seongjin-yoon/can-based-autonomous-delivery-car/docs/팀 Catnip 프로젝트 수행계획서_인텔 1차 프로젝트.pdf

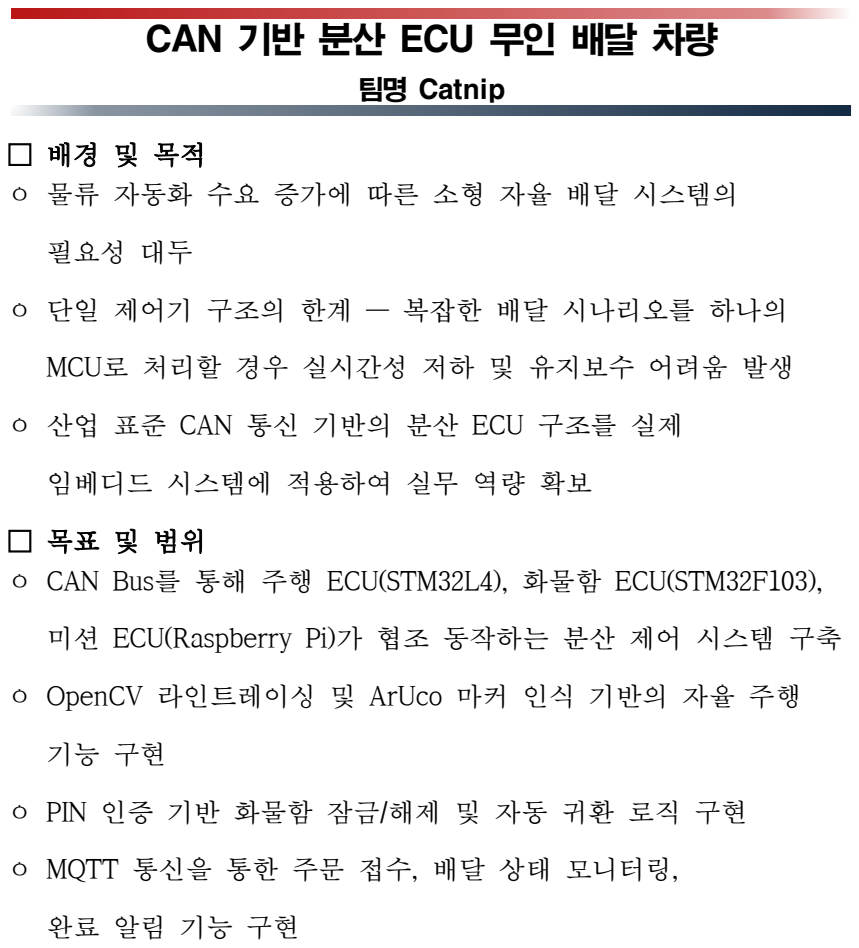
[picture p32: figure]
CAN 기반 분산 ECU 무인 배달 차량; 팀명 Catnip; ㅇ 물류 자동화 수요 증가에 따른 소형 자율 배달 시스템의; 필요성 대두; ㅇ 단일 제어기 구조의 한계 — 복잡한 배달 시나리오를 하나의; MCU로 처리할 경우 실시간성 저하 및 유지보수 어려움 발생; ㅇ 산업 표준 CAN 통신 기반의 분산 ECU 구조를 실제; 임베디드 시스템에 적용하여 실무 역량 확보; ㅇ OpenCV 라인트레이싱 및 ArUco 마커 인식 기반의 자율 주행; ㅇ PIN 인증 기반 화물함 잠금/해제 및 자동 귀환 로직 구현; ㅇ MQTT 통신을 통한 주문 접수, 배달 상태 모니터링,

ㅇ CAN Bus를 통해 주행 ECU(STM32L4), 화물함 ECU(STM32F103),

미션 ECU(Raspberry Pi)가 협조 동작하는 분산 제어 시스템 구축

ㅇ Qt 기반 클라이언트 UI에서 주문부터 배달 완료까지

전체 시나리오 동작 확인

□ 주요 기술 및 도구
ㅇ STM32L4, STM32F103, Raspberry Pi 5, CAN Bus(250kbps),

MQTT(Mosquitto), OpenCV, ArUco, Qt6, C/C++, SQLite

□ 주요 기능 및 예상 결과물
ㅇ CAN 프로토콜 기반 다중 ECU 분산 제어 (주행 / 화물함 / 미션)

ㅇ 라인트레이싱 + 교차로 판단 + 목적지별 경로 분기 자율 주행

ㅇ PIN 인증 기반 화물함 자동 개폐 및 미수령 시 자동 귀환

ㅇ MQTT 기반 실시간 주문·배달 상태 관리 서버 및 Qt 클라이언트 앱

□ 팀 구성 및 역할

성명 | 역할 | 성명 | 역할

구영모
(PM)

하드웨어 제작, 주행
ECU(STM32L$) - CAN
통신, 속도 제어 및
RPM 측정 뼈대 코드
작성, 화물함 ECU
(STM32F103) — CAN
통신

최지호
(Server)

서버 (RPi) — MQTT
브로커, SQLite DB,
주문 처리 로직, 클라이언트 UI (RPi) — Qt6 주문 앱, 배달 완료

알림, MQTT 연동

인수민
(PL)
윤성진
(Vision)

주행 테스트, 주행 ECU (STM32L4) — PID 속도 제어, 엔코더

RPM 측정, 상태머신, CAN/MQTT 연동

미션 ECU (RPi) — 라인트레이싱, ArUco

인식(Vision 담당),
마일스톤 제작

김민우
(QA)

화물함 ECU
(STM32F103) — PIN
인증, 서보 제어, CAN
통신 테스트, 클라이언트 UI (RPi) — Qt6 UX, 하드웨어

테스트, Flow Chart
제작

□ 프로젝트 일정

항목 | W+1 | W+2 | W+3 | W+4 | W+5 | W+6
주제 선정 및 설계
CAN 통신 및
ECU 개발
자율 주행 및
인증 구현
MQTT 서버/
Qt 클라이언트
통합 테스트
및 시연

□ 기대효과
ㅇ CAN Bus 기반 분산 ECU 구조를 통해 자동차·산업 제어 분야의 실무 아키텍처 직접 경험
ㅇ 실시간 제어(STM32) + 고수준 처리(Raspberry Pi) + 네트워크 통신(MQTT)을 통합한 풀스택 임베디드 시스템 구현 역량 확보 ㅇ 소형 무인 배달 차량 플랫폼으로서 물류 자동화 서비스 적용 가능성 확인
