seongjin-yoon/can-based-autonomous-delivery-car/assets/can.png

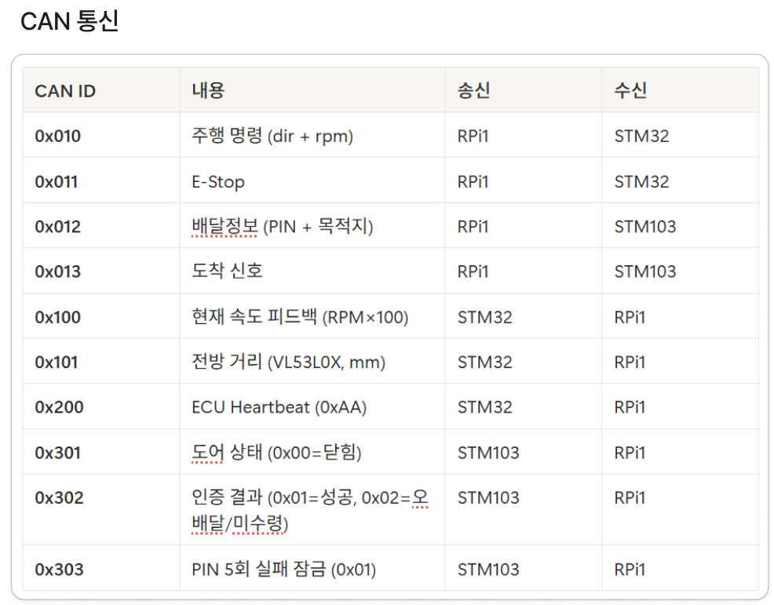
assets/can.png
