seongjin-yoon/can-based-autonomous-delivery-car/assets/cargo_hw.png

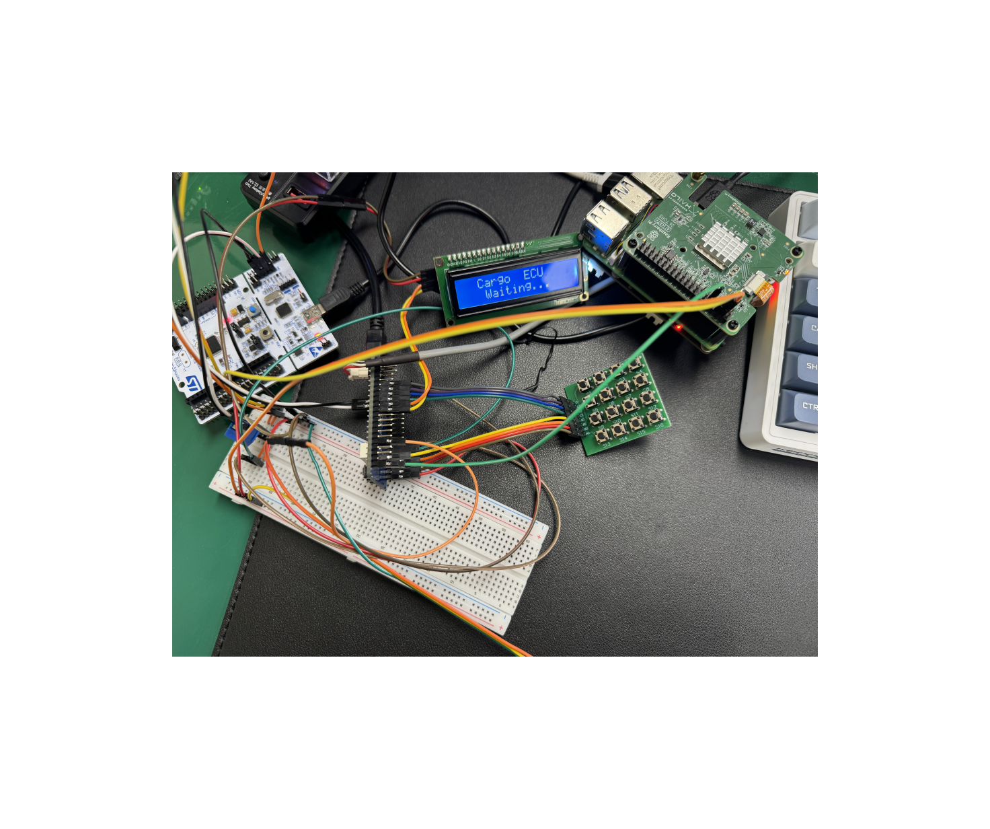
assets/cargo_hw.png
