seongjin-yoon/can-based-autonomous-delivery-car/assets/CATNIP (9).png

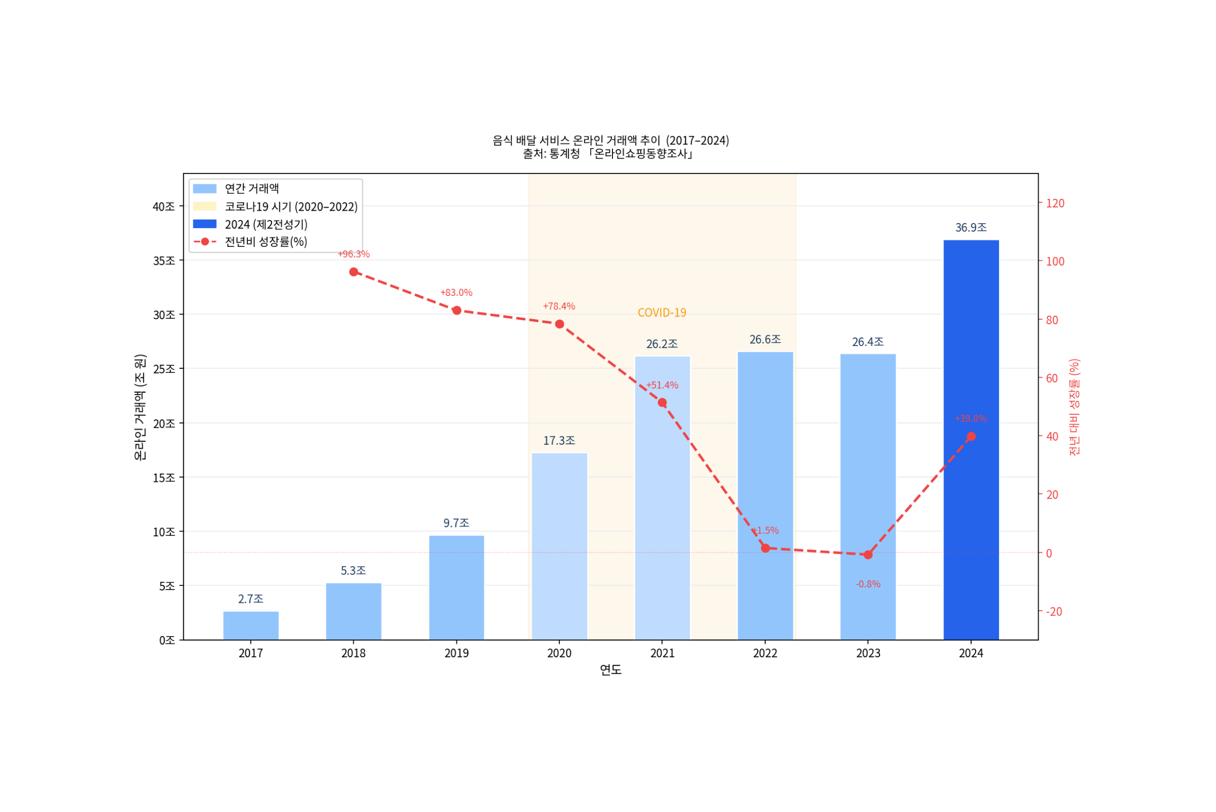
assets/CATNIP (9).png
