seongjin-yoon/can-based-autonomous-delivery-car/assets/CATNIP (11).png

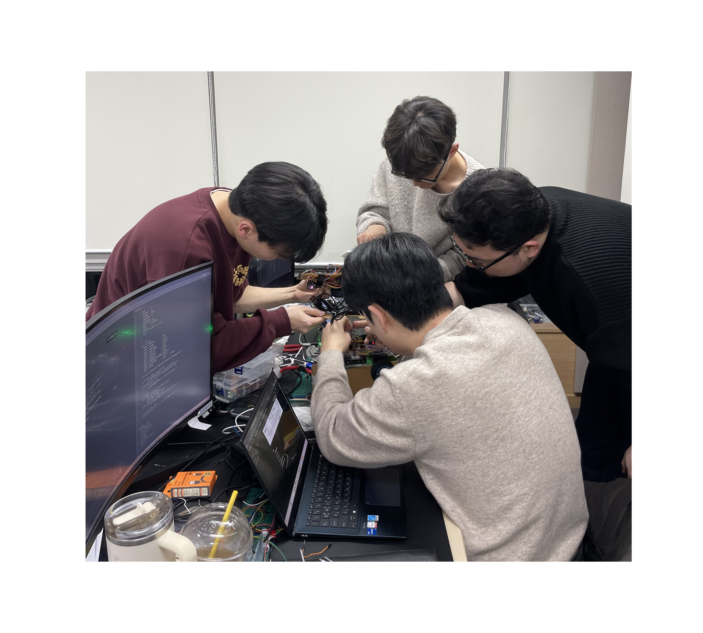
assets/CATNIP (11).png
