seongjin-yoon/can-based-autonomous-delivery-car/assets/hw (2).png

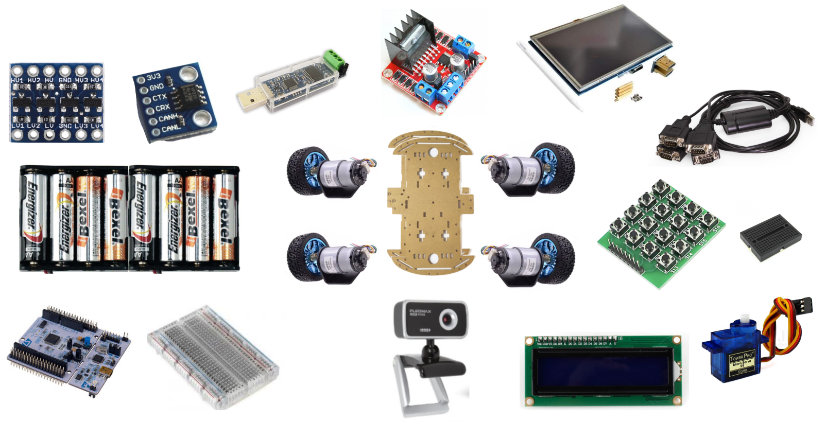
assets/hw (2).png
