seongjin-yoon/can-based-autonomous-delivery-car/assets/hw.png

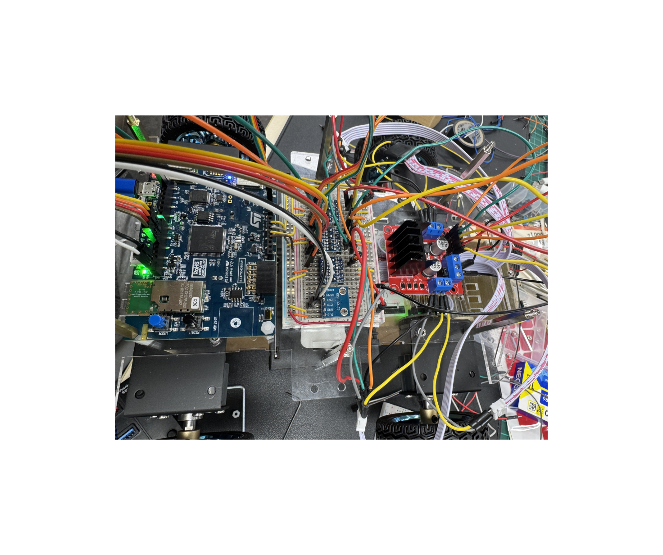
assets/hw.png
