seongjin-yoon/can-based-autonomous-delivery-car/assets/line_tracer3.png

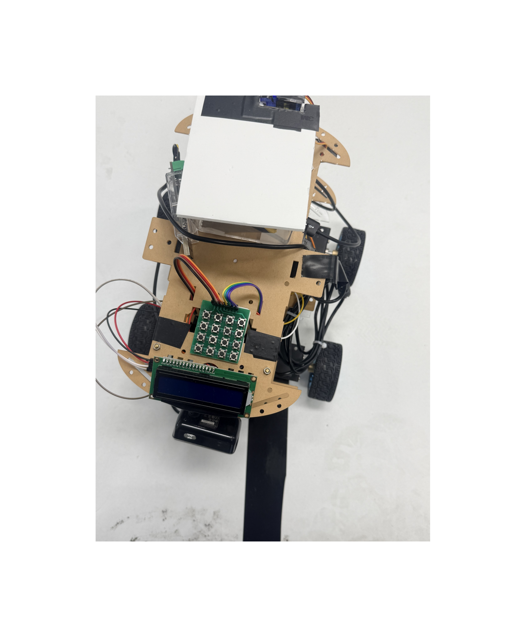
assets/line_tracer3.png
