seongjin-yoon/can-based-autonomous-delivery-car/assets/line_tracer5.png

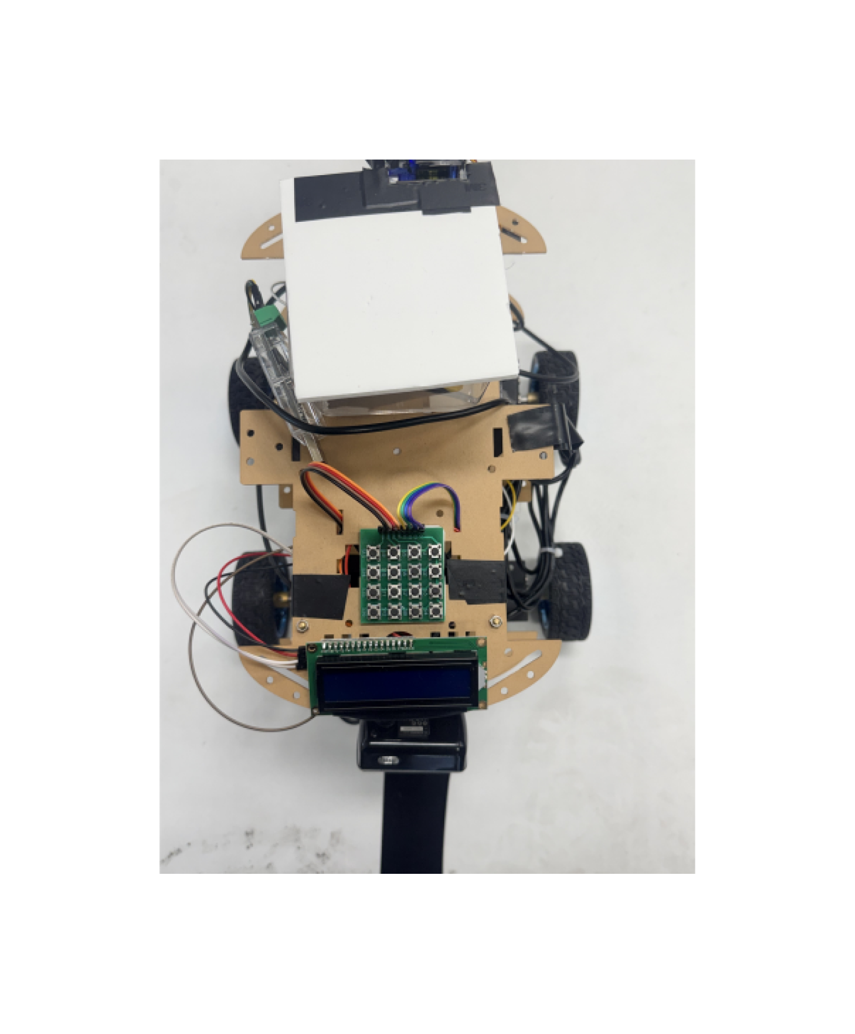
assets/line_tracer5.png
