seongjin-yoon/can-based-autonomous-delivery-car/assets/line_tracer6.png

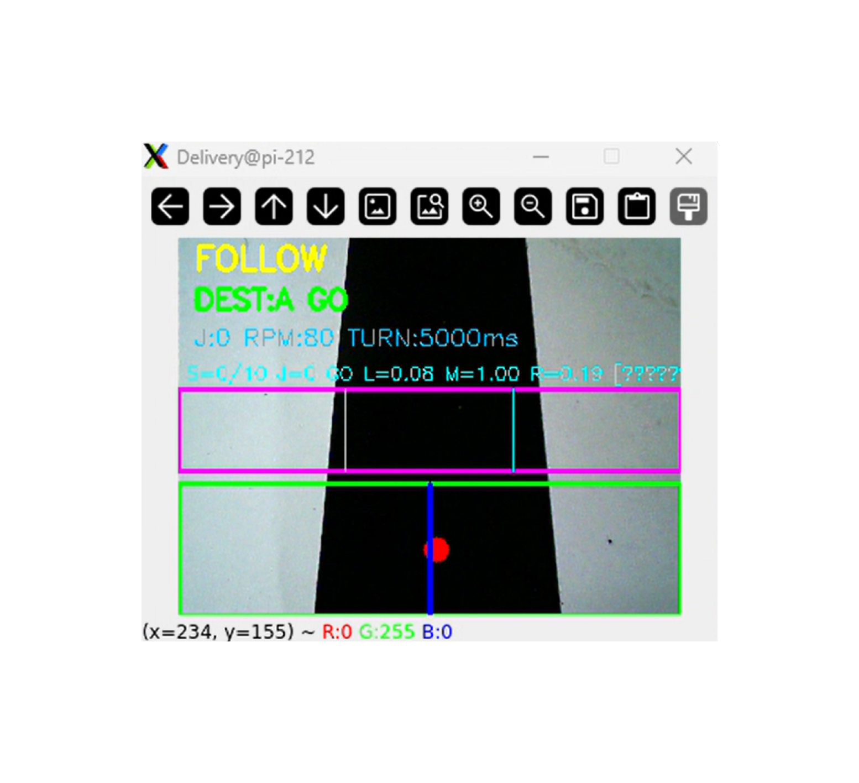
assets/line_tracer6.png
