seongjin-yoon/can-based-autonomous-delivery-car/assets/line_tracer.png

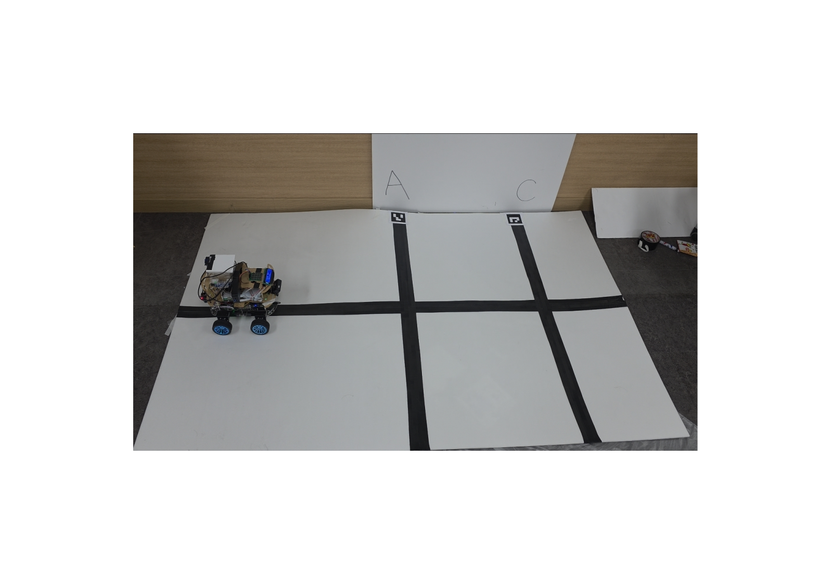
assets/line_tracer.png
