seongjin-yoon/can-based-autonomous-delivery-car/assets/line_tracer_2.png

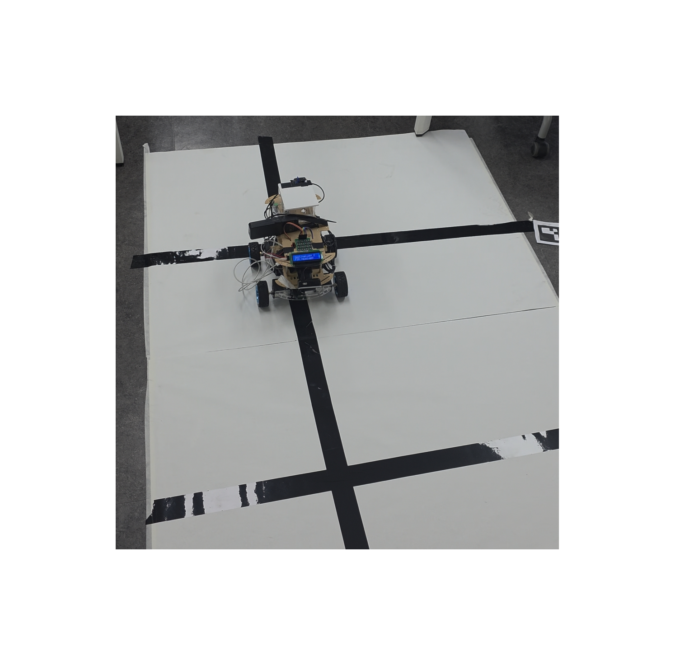
assets/line_tracer_2.png
