seongjin-yoon/can-based-autonomous-delivery-car/assets/mqtt.png

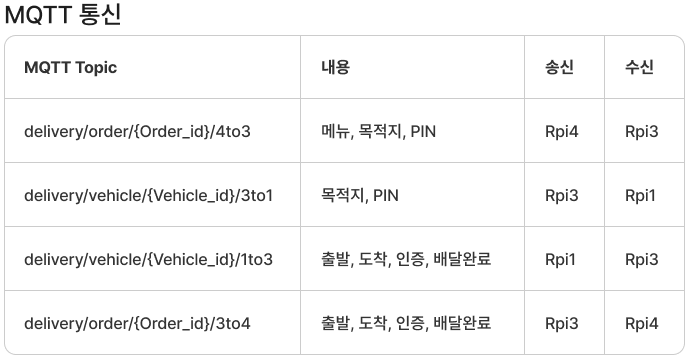
assets/mqtt.png
