seongjin-yoon/can-based-autonomous-delivery-car/assets/opencv.png

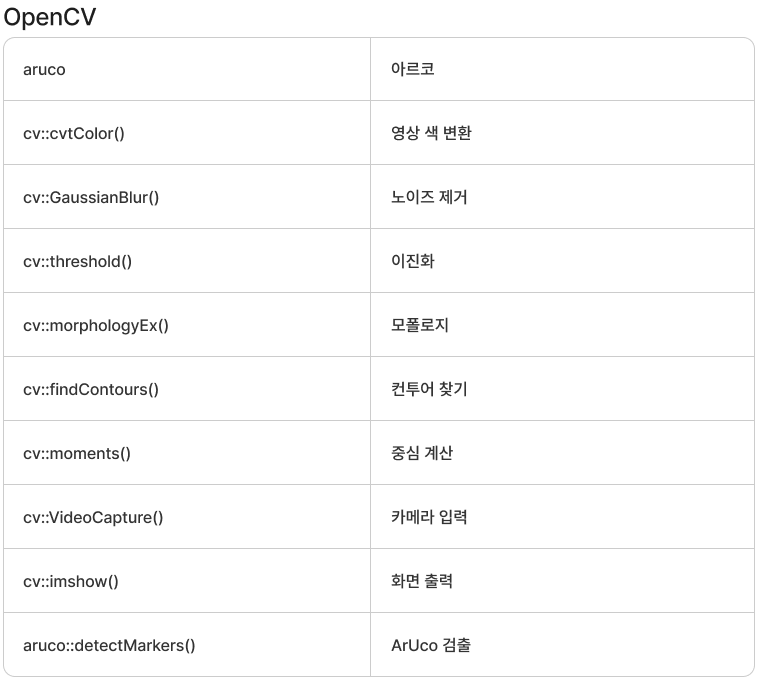
assets/opencv.png
