seongjin-yoon/can-based-autonomous-delivery-car/assets/rc_car_photo.png

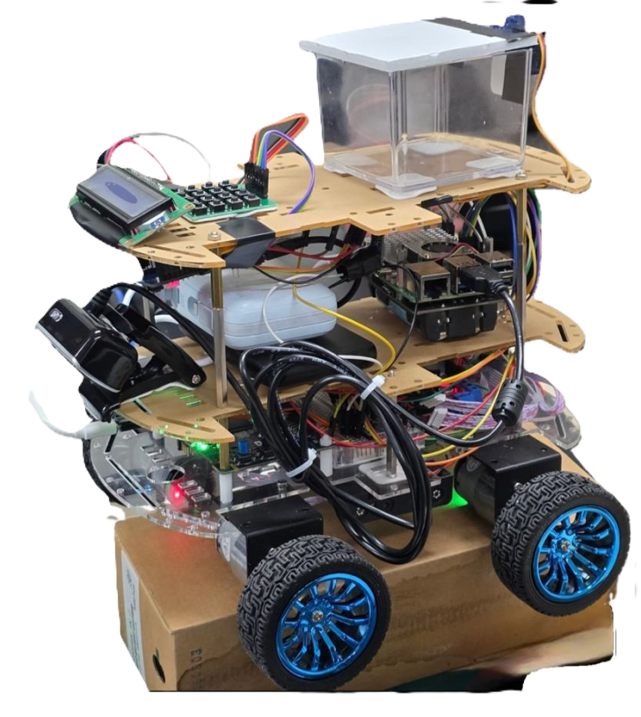
assets/rc_car_photo.png
