seongjin-yoon/can-based-autonomous-delivery-car/assets/st_link.png

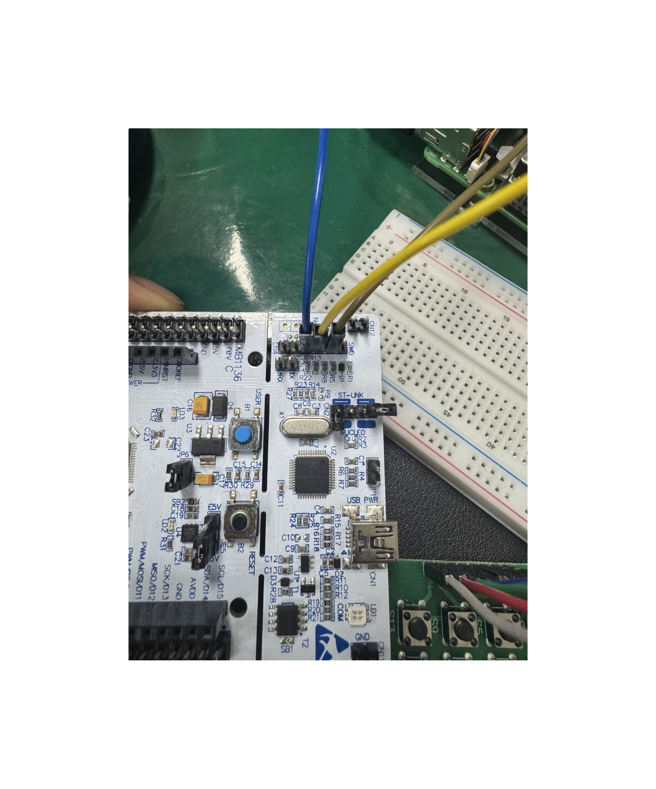
assets/st_link.png
