seongjin-yoon/can-based-autonomous-delivery-car/stmL4_drive/Core/Inc/main.h

#define BUTTON_EXTI13_Pin GPIO_PIN_13
#define BUTTON_EXTI13_GPIO_Port GPIOC
#define BUTTON_EXTI13_EXTI_IRQn EXTI15_10_IRQn
#define MOTOR_IN1_Pin GPIO_PIN_2
#define MOTOR_IN1_GPIO_Port GPIOC
#define MOTOR_IN2_Pin GPIO_PIN_3
#define MOTOR_IN2_GPIO_Port GPIOC
#define MOTOR_IN3_Pin GPIO_PIN_4
#define MOTOR_IN3_GPIO_Port GPIOC
#define MOTOR_IN4_Pin GPIO_PIN_5
#define MOTOR_IN4_GPIO_Port GPIOC
#define LED2_Pin GPIO_PIN_14
#define LED2_GPIO_Port GPIOB
#define USB_OTG_FS_PWR_EN_Pin GPIO_PIN_12
#define USB_OTG_FS_PWR_EN_GPIO_Port GPIOD
#define VL53L0X_XSHUT_Pin GPIO_PIN_6
#define VL53L0X_XSHUT_GPIO_Port GPIOC
#define VL53L0X_GPIO1_EXTI7_Pin GPIO_PIN_7
#define VL53L0X_GPIO1_EXTI7_GPIO_Port GPIOC
#define VL53L0X_GPIO1_EXTI7_EXTI_IRQn EXTI9_5_IRQn
#define LED3_WIFI__LED4_BLE_Pin GPIO_PIN_9
#define LED3_WIFI__LED4_BLE_GPIO_Port GPIOC
#define SYS_JTMS_SWDIO_Pin GPIO_PIN_13
#define SYS_JTMS_SWDIO_GPIO_Port GPIOA
#define SYS_JTCK_SWCLK_Pin GPIO_PIN_14
#define SYS_JTCK_SWCLK_GPIO_Port GPIOA
