seongjin-yoon/can-based-autonomous-delivery-car/rpi1_mission/mission_ecu.cpp

/*
 * delivery_mqtt_merge10.cpp
 * 라인트레이싱 + ArUco + MQTT 통합 버전
 *
 * 수정사항 (merge10):
 *   1. VehicleMQTT 클래스를 recv_can 앞으로 이동 (컴파일 오류 수정)
 *   2. recv_can(sock) → recv_can(sock, mqtt) 인자 수정
 *   3. MQTT 구독 토픽 /destination → /order 수정
 *   4. last_junc = t → last_junc = 0 (첫 교차로 쿨다운 제거)
 *   5. 유턴 후 복귀 시도 last_junc = 0 (복귀 첫 교차로도 즉시 인식)
 *
 * 컴파일:
 *   g++ delivery_mqtt_merge10.cpp -o delivery10 \
 *       $(pkg-config --cflags --libs opencv4) \
 *       -lmosquittopp -lpthread
 * 실행:
 *   ./delivery10 [broker_ip]
 */

#include <opencv2/opencv.hpp>
#include <opencv2/aruco.hpp>
#include <mosquittopp.h>
#include <nlohmann/json.hpp>
#include <stdio.h>
#include <stdlib.h>
#include <string.h>
#include <unistd.h>
#include <termios.h>
#include <net/if.h>
#include <sys/socket.h>
#include <sys/ioctl.h>
#include <linux/can.h>
#include <linux/can/raw.h>
#include <stdint.h>
#include <sys/select.h>
#include <time.h>
#include <cmath>
#include <fcntl.h>
#include <errno.h>
#include <vector>
#include <thread>
#include <atomic>
#include <string>
#include <sstream>
#include <iomanip>

using json = nlohmann::json;

// ===================== CAN ID 정의 =====================
#define CAN_MOTOR_CMD     0x010
#define CAN_MOTOR_ESTOP   0x011
#define CAN_CARGO_INFO    0x012
#define CAN_CARGO_ARRIVE  0x013
#define CAN_DOOR_STATUS   0x301
#define CAN_AUTH_RESULT   0x302
#define CAN_LOCKED        0x303

// ===================== 모터 명령 코드 =====================
#define DIR_STOP      0
#define DIR_FORWARD   1
#define DIR_BACKWARD  2
#define DIR_LEFT      3
#define DIR_RIGHT     4
#define DIR_UTURN     5

// ===================== 주행 파라미터 =====================
#define DEFAULT_RPM       50.0f
#define TURN_RPM          150.0f
#define UTURN_RPM         200.0f   // ★ 유턴은 더 강하게
#define STRAIGHT_DEADBAND 50

// ===================== 교차로 감지 파라미터 =====================
#define JUNC_STREAK       2
#define JUNC_START_DELAY  3000
#define JUNC_COOLDOWN_MS  3500
#define HIGH_TH           0.40f
#define HIGH_TH_ONE       0.65f
#define MID_TH            0.40f

// ===================== 상태 지속 시간 =====================
#define DUR_JUNC_STOP_MS      800
#define DUR_STRAIGHT_MS       2000
#define DUR_TURN_MS           3000
#define DUR_UTURN_MS          3000
#define DUR_REACQ_MS          1500   // ★ 500 → 1500ms (회전 후 라인 정렬 시간 확보)
#define DUR_REACQ_UTURN_MS    1000
#define REACQ_RPM             30.0f  // ★ 재조정 시 저속

// ===================== 상태머신 =====================
typedef enum {
    S_WAIT_CMD,
    S_FOLLOW,
    S_JUNC_STOP,
    S_JUNC_STRAIGHT,
    S_JUNC_LEFT,
    S_JUNC_RIGHT,
    S_REACQUIRE,
    S_REACQ_STABLE,        // ★ REACQ 완료 후 직진 안정화
    S_REACQUIRE_AFTER_UTURN,
    S_DELIVER_WAIT,
    S_PRE_UTURN,   // ★ 도어 닫힘 후 직진 → 유턴 준비
    S_UTURN,
    S_FINISHED
} State;

typedef enum { J_NONE, J_PLUS, J_T } JuncType;

// ===================== 전역 변수 =====================
static struct termios orig_termios;
static float          g_rpm         = DEFAULT_RPM;
static uint8_t        g_next_action = DIR_FORWARD;
static uint8_t        g_reacq_dir   = DIR_FORWARD; // ★ REACQUIRE 진입 방향

static std::atomic<int>  g_destination(0);
static std::atomic<bool> g_start_cmd(false);
static std::atomic<bool> g_running(true);
static std::atomic<bool> g_door_closed(false);
static std::string       g_delivery_id = "";
static std::string       g_vehicle_id  = "vehicle_001";

// ===================== 목적지별 교차로 행동 =====================
static uint8_t get_junction_action(int dest, int junc_count, bool returning) {
    if (!returning) {
        switch (dest) {
            case 1: if (junc_count == 0) return DIR_LEFT;    break;
            case 2: if (junc_count == 0) return DIR_RIGHT;   break;
            case 3:
                if (junc_count == 0) return DIR_FORWARD;
                if (junc_count == 1) return DIR_LEFT;
                break;
            case 4:
                if (junc_count == 0) return DIR_FORWARD;
                if (junc_count == 1) return DIR_RIGHT;
                break;
        }
    } else {
        switch (dest) {
            case 1: if (junc_count == 0) return DIR_RIGHT;   break;
            case 2: if (junc_count == 0) return DIR_LEFT;    break;
            case 3:
                if (junc_count == 0) return DIR_RIGHT;
                if (junc_count == 1) return DIR_FORWARD;
                break;
            case 4:
                if (junc_count == 0) return DIR_LEFT;
                if (junc_count == 1) return DIR_FORWARD;
                break;
        }
    }
    return DIR_FORWARD;
}

static int get_target_aruco(int dest) { return dest; }
static int get_max_junc(int dest) {
    if (dest == 1 || dest == 2) return 1;
    return 2;
}

// ===================== 유틸 =====================
static uint64_t now_ms() {
    struct timespec ts;
    clock_gettime(CLOCK_MONOTONIC, &ts);
    return (uint64_t)ts.tv_sec * 1000ULL + ts.tv_nsec / 1000000ULL;
}

static std::string get_timestamp() {
    auto now = std::time(nullptr);
    auto tm  = *std::localtime(&now);
    std::ostringstream oss;
    oss << std::put_time(&tm, "%Y-%m-%d %H:%M:%S");
    return oss.str();
}

void term_raw_on() {
    struct termios raw;
    tcgetattr(STDIN_FILENO, &orig_termios);
    raw = orig_termios;
    raw.c_lflag &= ~(ICANON | ECHO);
    raw.c_cc[VMIN] = 1; raw.c_cc[VTIME] = 0;
    tcsetattr(STDIN_FILENO, TCSAFLUSH, &raw);
}
void term_raw_off() { tcsetattr(STDIN_FILENO, TCSAFLUSH, &orig_termios); }

// ===================== CAN 송신 =====================
void send_cmd(int sock, uint8_t dir, float rpm) {
    struct can_frame frame;
    memset(&frame, 0, sizeof(frame));
    frame.can_id  = CAN_MOTOR_CMD;
    frame.can_dlc = 3;
    uint16_t rpm_x10 = (uint16_t)(rpm * 10.0f);
    frame.data[0] = dir;
    frame.data[1] = (rpm_x10 >> 8) & 0xFF;
    frame.data[2] =  rpm_x10       & 0xFF;
    if (write(sock, &frame, sizeof(frame)) < 0)
        perror("CAN write");
}

void send_estop(int sock) {
    struct can_frame frame;
    memset(&frame, 0, sizeof(frame));
    frame.can_id  = CAN_MOTOR_ESTOP;
    frame.can_dlc = 1;
    frame.data[0] = 0xFF;
    write(sock, &frame, sizeof(frame));
}

void send_cargo_info(int sock, const std::string& pin, int dest) {
    struct can_frame frame;
    memset(&frame, 0, sizeof(frame));
    frame.can_id  = CAN_CARGO_INFO;
    frame.can_dlc = 6;
    frame.data[0] = 0x01;
    for (int i = 0; i < 4; i++)
        frame.data[1+i] = (pin.size() > (size_t)i) ? (pin[i] - '0') : 0;
    frame.data[5] = (uint8_t)dest;
    write(sock, &frame, sizeof(frame));
    printf("[CAN TX] 0x012 배달정보 전송 PIN=%s DEST=%d\n", pin.c_str(), dest);
}

void send_cargo_arrival(int sock) {
    struct can_frame frame;
    memset(&frame, 0, sizeof(frame));
    frame.can_id  = CAN_CARGO_ARRIVE;
    frame.can_dlc = 1;
    frame.data[0] = 0x01;
    write(sock, &frame, sizeof(frame));
    printf("[CAN TX] 0x013 도착 신호 → 적재함ECU\n");
}

// ===================== ArUco 감지 =====================
static int detect_aruco(const cv::Mat& frame) {
    static cv::aruco::Dictionary dict =
        cv::aruco::getPredefinedDictionary(cv::aruco::DICT_4X4_50);
    static cv::aruco::DetectorParameters params;
    static cv::aruco::ArucoDetector detector(dict, params);

    std::vector<int> ids;
    std::vector<std::vector<cv::Point2f>> corners, rejected;
    detector.detectMarkers(frame, corners, ids, rejected);
    if (ids.empty()) return -1;

    int best = 0; double best_area = 0;
    for (int i = 0; i < (int)ids.size(); i++) {
        double a = fabs(cv::contourArea(corners[i]));
        if (a > best_area) { best_area = a; best = i; }
    }
    return ids[best];
}

// ===================== 라인 추적 =====================
static uint8_t follow_line(const cv::Mat& frame, int& err_out, cv::Mat& vis) {
    int H = frame.rows, W = frame.cols;
    int y0 = (int)(H * 0.65);
    cv::Mat roi = frame(cv::Rect(0, y0, W, H - y0));

    cv::Mat gray, blur, bin;
    cv::cvtColor(roi, gray, cv::COLOR_BGR2GRAY);
    cv::GaussianBlur(gray, blur, cv::Size(7, 7), 0);
    cv::threshold(blur, bin, 0, 255, cv::THRESH_BINARY_INV | cv::THRESH_OTSU);
    cv::morphologyEx(bin, bin, cv::MORPH_OPEN,
        cv::getStructuringElement(cv::MORPH_RECT, cv::Size(3, 3)));

    std::vector<std::vector<cv::Point>> contours;
    cv::findContours(bin, contours, cv::RETR_EXTERNAL, cv::CHAIN_APPROX_SIMPLE);

    int best = -1; double best_area = 0;
    for (int i = 0; i < (int)contours.size(); i++) {
        double a = cv::contourArea(contours[i]);
        if (a > best_area) { best_area = a; best = i; }
    }

    if (best < 0 || best_area < 500) { err_out = 0; return DIR_FORWARD; }

    cv::Moments m = cv::moments(contours[best]);
    int cx = (m.m00 != 0) ? (int)(m.m10 / m.m00) : W / 2;
    err_out = cx - W / 2;

    cv::circle(vis, cv::Point(cx, y0 + roi.rows / 2), 8, cv::Scalar(0, 0, 255), -1);
    cv::rectangle(vis, cv::Point(0, y0), cv::Point(W, H), cv::Scalar(0, 255, 0), 2);
    cv::line(vis, cv::Point(W/2, y0), cv::Point(W/2, H), cv::Scalar(255, 0, 0), 2);

    if (abs(err_out) <= STRAIGHT_DEADBAND) return DIR_FORWARD;
    return (err_out < 0) ? DIR_LEFT : DIR_RIGHT;
}

// ===================== 교차로 감지 =====================
static JuncType classify_junction(const cv::Mat& bin_roi,
                                   float& dbg_L, float& dbg_M, float& dbg_R)
{
    int w = bin_roi.cols, h = bin_roi.rows;
    int lw = w / 3, mw = w / 3, rw = w - 2*(w/3);

    dbg_L = (float)cv::countNonZero(bin_roi(cv::Rect(0,     0, lw, h))) / (float)(lw * h);
    dbg_M = (float)cv::countNonZero(bin_roi(cv::Rect(lw,    0, mw, h))) / (float)(mw * h);
    dbg_R = (float)cv::countNonZero(bin_roi(cv::Rect(lw+mw, 0, rw, h))) / (float)(rw * h);

    if (dbg_L >= HIGH_TH && dbg_M >= HIGH_TH && dbg_R >= HIGH_TH)
        return J_PLUS;
    if (dbg_L >= HIGH_TH && dbg_R >= HIGH_TH)
        return J_T;
    if (dbg_R >= HIGH_TH_ONE && dbg_L >= 0.30f && dbg_M >= MID_TH)
        return J_T;
    if (dbg_L >= HIGH_TH_ONE && dbg_R >= 0.30f && dbg_M >= MID_TH)
        return J_T;

    return J_NONE;
}

// ===================== MQTT 클라이언트 =====================
// ★ recv_can 보다 앞에 선언 (컴파일 오류 수정)
class VehicleMQTT : public mosqpp::mosquittopp {
public:
    bool        connected = false;
    std::string last_pin  = "0000";
    int         last_dest = 1;

    VehicleMQTT() : mosqpp::mosquittopp("rpi1-vehicle") {
        username_pw_set("hoji", "1234");
    }

    bool start(const std::string& host, int port = 1883) {
        mosqpp::lib_init();
        int rc = connect(host.c_str(), port, 60);
        if (rc != MOSQ_ERR_SUCCESS) {
            fprintf(stderr, "[MQTT] 연결 실패 rc=%d - 오프라인 모드\n", rc);
            return false;
        }
        loop_start();
        for (int i = 0; i < 50 && !connected; i++)
            std::this_thread::sleep_for(std::chrono::milliseconds(100));
        return connected;
    }

    void pub(const std::string& topic, const json& data, int qos = 1) {
        if (!connected) return;
        std::string payload = data.dump();
        publish(nullptr, topic.c_str(), payload.size(), payload.c_str(), qos, false);
    }

    void send_status(const std::string& status) {
        json msg = {
            {"vehicle_id",  g_vehicle_id},
            {"order_id",    g_delivery_id},
            {"status",      status},
            {"timestamp",   get_timestamp()}
        };
        pub("delivery/vehicle/" + g_vehicle_id + "/status", msg, 0);
    }

    void send_start(int dest) {
        const char* dn = (dest==1)?"A":(dest==2)?"B":(dest==3)?"C":"D";
        json msg = {
            {"vehicle_id",  g_vehicle_id},
            {"order_id",    g_delivery_id},
            {"destination", std::string(dn)},
            {"status",      "in_transit"},
            {"timestamp",   get_timestamp()}
        };
        pub("delivery/vehicle/" + g_vehicle_id + "/1to3", msg, 1);
        printf("[MQTT] 출발 → 목적지 %s\n", dn);
    }

    void send_arrived(int dest) {
        const char* dn = (dest==1)?"A":(dest==2)?"B":(dest==3)?"C":"D";
        json msg = {
            {"vehicle_id",  g_vehicle_id},
            {"order_id",    g_delivery_id},
            {"destination", std::string(dn)},
            {"status",      "arrived"},
            {"timestamp",   get_timestamp()}
        };
        pub("delivery/vehicle/" + g_vehicle_id + "/1to3", msg, 1);
        printf("[MQTT] 도착! 목적지 %s\n", dn);
    }

    void send_complete() {
        json msg = {
            {"vehicle_id",  g_vehicle_id},
            {"order_id",    g_delivery_id},
            {"status",      "completed"},
            {"timestamp",   get_timestamp()}
        };
        pub("delivery/vehicle/" + g_vehicle_id + "/1to3", msg, 1);
        printf("[MQTT] 배달 완료\n");
    }

protected:
    void on_connect(int rc) override {
        if (rc == 0) {
            connected = true;
            // ★ /destination → /order 수정
            subscribe(nullptr,
                ("delivery/vehicle/" + g_vehicle_id + "/order").c_str(), 1);
            printf("[MQTT] 연결됨\n");
            printf("[MQTT] 구독: delivery/vehicle/%s/order\n", g_vehicle_id.c_str());
        }
    }

    void on_disconnect(int rc) override {
        connected = false;
        printf("[MQTT] 연결 끊김 rc=%d\n", rc);
    }

    void on_message(const struct mosquitto_message* msg) override {
        std::string topic(msg->topic);
        std::string payload((char*)msg->payload, msg->payloadlen);
        try {
            auto data = json::parse(payload);
            if (topic.find("/order") != std::string::npos) {
                std::string dest_str = data["destination"].get<std::string>();
                int dest = (dest_str=="A")?1:(dest_str=="B")?2:
                           (dest_str=="C")?3:4;
                g_delivery_id = data.value("order_id", "");
                last_pin      = data.value("pin", "0000");
                last_dest     = dest;
                g_destination = dest;
                g_start_cmd   = true;
                printf("\n[MQTT] 출동 명령! 목적지=%s PIN=%s order_id=%s\n",
                       dest_str.c_str(), last_pin.c_str(), g_delivery_id.c_str());
            }
        } catch (...) {
            printf("[MQTT] JSON 파싱 오류\n");
        }
    }
};

// ===================== CAN 수신 =====================
// ★ VehicleMQTT 클래스 선언 후에 위치 + mqtt 인자 추가
void recv_can(int sock, VehicleMQTT& mqtt) {
    struct can_frame frame;
    fd_set fds;
    struct timeval tv = {0, 0};
    FD_ZERO(&fds);
    FD_SET(sock, &fds);
    if (select(sock + 1, &fds, NULL, NULL, &tv) > 0) {
        if (read(sock, &frame, sizeof(frame)) > 0) {
            if (frame.can_id == CAN_DOOR_STATUS && frame.data[0] == 0x00) {
                printf("\n[CAN RX] 0x301=0x00 도어 닫힘 → 유턴!\n");
                g_door_closed = true;
            }
            else if (frame.can_id == CAN_AUTH_RESULT && frame.data[0] == 0x01) {
                printf("\n[CAN RX] 0x302=0x01 인증 성공\n");
                json msg = {
                    {"vehicle_id",  g_vehicle_id},
                    {"order_id",    g_delivery_id},
                    {"event",       "pin_success"},
                    {"message",     "PIN 인증 성공 - 적재함 열림"},
                    {"timestamp",   get_timestamp()}
                };
                mqtt.pub("delivery/vehicle/" + g_vehicle_id + "/alert", msg, 1);
                printf("[MQTT] 인증 성공 알림 전송\n");
            }
            else if (frame.can_id == CAN_AUTH_RESULT && frame.data[0] == 0x02) {
                printf("\n[CAN RX] 0x302=0x02 오배달/미수령 → 즉시 유턴\n");
                g_door_closed = true;
            }
            else if (frame.can_id == CAN_LOCKED && frame.data[0] == 0x01) {
                printf("\n[CAN RX] 0x303=0x01 PIN 5회 실패 잠금!\n");
                json msg = {
                    {"vehicle_id",  g_vehicle_id},
                    {"order_id",    g_delivery_id},
                    {"event",       "pin_locked"},
                    {"message",     "PIN 5회 실패 - 적재함 잠금"},
                    {"timestamp",   get_timestamp()}
                };
                mqtt.pub("delivery/vehicle/" + g_vehicle_id + "/alert", msg, 1);
                printf("[MQTT] 잠금 알림 전송\n");
            }
        }
    }
}

// ===================== 메인 =====================
int main(int argc, char* argv[]) {
    std::string broker_host = "10.42.0.1";
    if (argc > 1) broker_host = argv[1];

    printf("=== 배달 차량 merge10 ===\n");
    printf("목적지: A=1 B=2 C=3 D=4\n");
    printf("키: q=종료 e=E-Stop 1/2/3/4=수동목적지설정\n");
    printf("브로커: %s\n\n", broker_host.c_str());

    // CAN 초기화
    int sock = socket(PF_CAN, SOCK_RAW, CAN_RAW);
    if (sock < 0) { perror("socket"); return 1; }
    struct ifreq ifr;
    strcpy(ifr.ifr_name, "can0");
    if (ioctl(sock, SIOCGIFINDEX, &ifr) < 0) { perror("ioctl"); return 1; }
    struct sockaddr_can addr;
    memset(&addr, 0, sizeof(addr));
    addr.can_family  = AF_CAN;
    addr.can_ifindex = ifr.ifr_ifindex;
    if (bind(sock, (struct sockaddr*)&addr, sizeof(addr)) < 0)
    { perror("bind"); return 1; }

    // 카메라 초기화
    cv::VideoCapture cap("/dev/video0");
    if (!cap.isOpened()) cap.open(0);
    if (!cap.isOpened()) { fprintf(stderr, "카메라 오픈 실패\n"); return 1; }
    cap.set(cv::CAP_PROP_FRAME_WIDTH,  320);
    cap.set(cv::CAP_PROP_FRAME_HEIGHT, 240);
    cap.set(cv::CAP_PROP_FPS, 30);
    cap.set(cv::CAP_PROP_BUFFERSIZE, 1);

    // MQTT 초기화
    VehicleMQTT mqtt;
    bool mqtt_ok = mqtt.start(broker_host);
    if (!mqtt_ok) printf("[MQTT] 오프라인 모드 - 키보드로 목적지 설정\n");

    // Heartbeat 스레드
    std::thread hb([&mqtt]() {
        while (g_running) {
            std::string st = (g_destination == 0) ? "idle" : "in_transit";
            mqtt.send_status(st);
            std::this_thread::sleep_for(std::chrono::milliseconds(2000));
        }
    });
    hb.detach();

    term_raw_on();

    State    state      = S_WAIT_CMD;
    uint64_t state_ts   = now_ms();
    uint64_t last_junc  = 0;
    uint64_t last_tx    = 0;
    uint64_t start_ts   = now_ms();
    int      streak     = 0;
    int      junc_count = 0;
    int      dest       = 0;
    bool     returning  = false;

    printf("MQTT 출동 명령 대기 중...\n");

    while (1) {
        cv::Mat frame;
        for (int i = 0; i < 2; i++) cap.grab();
        if (!cap.retrieve(frame) || frame.empty()) continue;

        uint64_t t   = now_ms();
        uint64_t dt  = t - state_ts;
        uint8_t  cmd = DIR_STOP;
        cv::Mat  vis = frame.clone();

        recv_can(sock, mqtt);  // ★ mqtt 인자 추가

        // 키 입력
        {
            fd_set fds; struct timeval tv = {0, 0};
            FD_ZERO(&fds); FD_SET(STDIN_FILENO, &fds);
            if (select(STDIN_FILENO+1, &fds, NULL, NULL, &tv) > 0) {
                char key = getchar();
                if (key == 'q') { send_cmd(sock, DIR_STOP, 0); goto exit_loop; }
                if (key == 'e') { send_estop(sock); printf("\n[E-Stop]\n"); }
                if (key=='1'||key=='2'||key=='3'||key=='4') {
                    g_destination = key - '0';
                    g_start_cmd   = true;
                    printf("\n[수동] 목적지 %c 설정\n", key);
                }
            }
        }

        switch (state) {

        case S_WAIT_CMD:
            cmd = DIR_STOP;
            if ((t - last_tx) >= 50) {
                send_cmd(sock, DIR_STOP, 0);
                last_tx = t;
            }
            if (g_start_cmd) {
                g_start_cmd   = false;
                g_door_closed = false;
                dest          = g_destination.load();
                junc_count    = 0;
                streak        = 0;
                returning     = false;
                start_ts      = t;
                last_junc     = 0;   // ★ 첫 교차로 쿨다운 없이 바로 인식
                state         = S_FOLLOW;
                state_ts      = t;
                const char* dn = (dest==1)?"A":(dest==2)?"B":(dest==3)?"C":"D";
                printf("\n[출발] 목적지: %s\n", dn);
                send_cargo_info(sock, mqtt.last_pin, dest);
                mqtt.send_start(dest);
            }
            break;

        case S_FOLLOW: {
            int aid = detect_aruco(frame);

            if (!returning && dest > 0 && aid == get_target_aruco(dest)) {
                printf("\n[도착] ArUco ID=%d 감지! 즉시 정지\n", aid);
                send_cmd(sock, DIR_STOP, 0);
                last_tx  = t;
                send_cargo_arrival(sock);
                g_door_closed = false;
                state    = S_DELIVER_WAIT;
                state_ts = t;
                mqtt.send_arrived(dest);
                printf("[대기] PIN 인증 후 도어 닫힘 대기 중...\n");
                break;
            }

            if (returning && aid == 0) {
                printf("\n[복귀 완료] ArUco ID=0 감지!\n");
                send_cmd(sock, DIR_STOP, 0);
                last_tx  = t;
                state    = S_FINISHED;
                state_ts = t;
                break;
            }

            // 교차로 감지
            int H = frame.rows, W = frame.cols;
            int yj0 = (int)(H * 0.40), yj1 = (int)(H * 0.62);
            cv::Mat jroi = frame(cv::Rect(0, yj0, W, yj1 - yj0));

            cv::Mat gray, blur, bin;
            cv::cvtColor(jroi, gray, cv::COLOR_BGR2GRAY);
            cv::GaussianBlur(gray, blur, cv::Size(5, 5), 0);
            cv::threshold(blur, bin, 0, 255, cv::THRESH_BINARY_INV | cv::THRESH_OTSU);
            cv::morphologyEx(bin, bin, cv::MORPH_OPEN,
                cv::getStructuringElement(cv::MORPH_RECT, cv::Size(3, 3)));

            float rL, rM, rR;
            JuncType jt = classify_junction(bin, rL, rM, rR);

            bool start_ok = (t - start_ts) >= JUNC_START_DELAY;
            bool cool     = (t - last_junc) > JUNC_COOLDOWN_MS;

            if (start_ok && cool && jt != J_NONE) streak++;
            else if (!cool || !start_ok)           streak = 0;
            else                                   streak = std::max(0, streak - 1);

            cv::rectangle(vis, cv::Point(0, yj0), cv::Point(W, yj1),
                          cv::Scalar(255, 0, 255), 2);
            cv::line(vis, cv::Point(W/3,   yj0), cv::Point(W/3,   yj1), cv::Scalar(255,255,0), 1);
            cv::line(vis, cv::Point(2*W/3, yj0), cv::Point(2*W/3, yj1), cv::Scalar(255,255,0), 1);

            char dbg[80];
            if (!start_ok) {
                int remain = (int)((JUNC_START_DELAY - (t - start_ts)) / 1000) + 1;
                snprintf(dbg, sizeof(dbg), "S=%d/%d J=%d %s L=%.2f M=%.2f R=%.2f [딜레이 %ds]",
                         streak, JUNC_STREAK, junc_count,
                         returning?"RET":"GO", rL, rM, rR, remain);
            } else {
                snprintf(dbg, sizeof(dbg), "S=%d/%d J=%d %s L=%.2f M=%.2f R=%.2f",
                         streak, JUNC_STREAK, junc_count,
                         returning?"RET":"GO", rL, rM, rR);
            }
            cv::putText(vis, dbg, cv::Point(5, 90),
                        cv::FONT_HERSHEY_SIMPLEX, 0.4, cv::Scalar(255,255,0), 1);

            if (start_ok && cool && streak >= JUNC_STREAK &&
                junc_count < get_max_junc(dest)) {

                streak    = 0;
                last_junc = t;

                uint8_t action = get_junction_action(dest, junc_count, returning);
                junc_count++;

                const char* an = (action==DIR_FORWARD)?"직진":
                                 (action==DIR_LEFT)?"좌회전":"우회전";
                printf("\n[교차로 %d번째] DEST:%d %s → %s (L=%.2f M=%.2f R=%.2f)\n",
                       junc_count, dest, returning?"복귀":"GO", an, rL, rM, rR);

                g_next_action = action;
                send_cmd(sock, DIR_STOP, 0);
                last_tx  = t;
                state    = S_JUNC_STOP;
                state_ts = t;
                break;
            }

            int err = 0;
            cmd = follow_line(frame, err, vis);
            if ((t - last_tx) >= 50) {
                float tx_rpm = (cmd == DIR_STOP) ? 0.0f : g_rpm;
                send_cmd(sock, cmd, tx_rpm);
                last_tx = t;
            }
            {
                static uint64_t last_log = 0;
                if (t - last_log >= 500) {
                    last_log = t;
                    const char* d2  = (cmd==DIR_FORWARD)?"STRAIGHT":(cmd==DIR_LEFT)?"LEFT":"RIGHT";
                    const char* dn2 = (dest==1)?"A":(dest==2)?"B":(dest==3)?"C":(dest==4)?"D":"?";
                    printf("\n[LOG %s] DIR:%-8s err:%4d | DEST:%s %s | JUNC:%d RPM:%.0f streak:%d L=%.2f M=%.2f R=%.2f",
                           get_timestamp().c_str(),
                           d2, err, dn2, returning?"RET":"GO",
                           junc_count, g_rpm, streak, rL, rM, rR);
                    fflush(stdout);
                }
            }
            break;
        }

        case S_JUNC_STOP:
            cmd = DIR_STOP;
            if ((t - last_tx) >= 50) {
                send_cmd(sock, DIR_STOP, 0);
                last_tx = t;
            }
            if (dt >= DUR_JUNC_STOP_MS) {
                if      (g_next_action == DIR_FORWARD) state = S_JUNC_STRAIGHT;
                else if (g_next_action == DIR_LEFT)    state = S_JUNC_LEFT;
                else                                   state = S_JUNC_RIGHT;
                state_ts = t;
                const char* an = (g_next_action==DIR_FORWARD)?"직진":
                                 (g_next_action==DIR_LEFT)?"좌회전":"우회전";
                printf("\n[행동 시작] %s (%dms)\n", an, DUR_TURN_MS);
            }
            break;

        case S_JUNC_STRAIGHT:
            cmd = DIR_FORWARD;
            if ((t - last_tx) >= 50) {
                send_cmd(sock, DIR_FORWARD, DEFAULT_RPM);
                last_tx = t;
            }
            if (dt >= DUR_STRAIGHT_MS) {
                g_reacq_dir = DIR_FORWARD; // 직진에서 왔으므로 직진 유지
                state    = S_REACQUIRE;
                state_ts = t;
                printf("\n[직진 완료] 라인 재탐색\n");
            }
            break;

        case S_JUNC_LEFT: {
            cmd = DIR_LEFT;
            if ((t - last_tx) >= 50) {
                send_cmd(sock, DIR_LEFT, TURN_RPM);
                last_tx = t;
            }
            {
                int H2 = frame.rows, W2 = frame.cols;
                int y02 = (int)(H2 * 0.65);
                cv::Mat roi2 = frame(cv::Rect(0, y02, W2, H2 - y02));
                cv::Mat gray2, blur2, bin2;
                cv::cvtColor(roi2, gray2, cv::COLOR_BGR2GRAY);
                cv::GaussianBlur(gray2, blur2, cv::Size(7,7), 0);
                cv::threshold(blur2, bin2, 0, 255, cv::THRESH_BINARY_INV | cv::THRESH_OTSU);
                cv::morphologyEx(bin2, bin2, cv::MORPH_OPEN,
                    cv::getStructuringElement(cv::MORPH_RECT, cv::Size(3,3)));
                std::vector<std::vector<cv::Point>> ctrs2;
                cv::findContours(bin2, ctrs2, cv::RETR_EXTERNAL, cv::CHAIN_APPROX_SIMPLE);
                double max_area2 = 0;
                for (auto& c : ctrs2) max_area2 = std::max(max_area2, cv::contourArea(c));

                // ★ 0~1000ms: 워밍업 (교차로 픽셀 벗어나는 시간, 무조건 좌회전)
                // ★ 1000ms~: 라인 감지되면 S_REACQUIRE, 라인 없으면 계속 좌회전
                // ★ 무게중심이 화면 왼쪽 절반에 있어야 진짜 새 라인 (교차로 잔상 아님)
                bool phase2  = (dt >= 2500); // ★ 1500→2500ms 워밍업 연장
                bool area_ok = (max_area2 >= 1500); // ★ area 상한 제거

                // 무게중심 계산
                bool cx_ok = false;
                if (area_ok && !ctrs2.empty()) {
                    int best_i = 0; double ba = 0;
                    for (int i = 0; i < (int)ctrs2.size(); i++) {
                        double a = cv::contourArea(ctrs2[i]);
                        if (a > ba) { ba = a; best_i = i; }
                    }
                    cv::Moments mm = cv::moments(ctrs2[best_i]);
                    if (mm.m00 > 0) {
                        int cx2 = (int)(mm.m10 / mm.m00);
                        // 좌회전 후 라인은 화면 왼쪽~중앙에 있어야 함
                        cx_ok = (cx2 < W2 * 0.7f);
                    }
                }
                bool line_ok = phase2 && area_ok && cx_ok;

                printf("\r[좌회전] %.1fs area:%.0f %s      ",
                       dt/1000.0f, max_area2,
                       !phase2 ? "warmup" : (line_ok ? "LINE!" : "searching..."));
                fflush(stdout);

                // ★ 라인 감지 시에만 REACQUIRE 전환 (타임아웃 없음 - 라인 찾을때까지 계속 회전)
                if (line_ok) {
                    printf("\n[좌회전 완료] 라인 감지 (area=%.0f, %.1fs)\n", max_area2, dt/1000.0f);
                    g_reacq_dir = DIR_LEFT;
                    state    = S_REACQUIRE;
                    state_ts = t;
                }
            }
            break;
        }

        case S_JUNC_RIGHT: {
            cmd = DIR_RIGHT;
            if ((t - last_tx) >= 50) {
                send_cmd(sock, DIR_RIGHT, TURN_RPM);
                last_tx = t;
            }
            {
                int H2 = frame.rows, W2 = frame.cols;
                int y02 = (int)(H2 * 0.65);
                cv::Mat roi2 = frame(cv::Rect(0, y02, W2, H2 - y02));
                cv::Mat gray2, blur2, bin2;
                cv::cvtColor(roi2, gray2, cv::COLOR_BGR2GRAY);
                cv::GaussianBlur(gray2, blur2, cv::Size(7,7), 0);
                cv::threshold(blur2, bin2, 0, 255, cv::THRESH_BINARY_INV | cv::THRESH_OTSU);
                cv::morphologyEx(bin2, bin2, cv::MORPH_OPEN,
                    cv::getStructuringElement(cv::MORPH_RECT, cv::Size(3,3)));
                std::vector<std::vector<cv::Point>> ctrs2;
                cv::findContours(bin2, ctrs2, cv::RETR_EXTERNAL, cv::CHAIN_APPROX_SIMPLE);
                double max_area2 = 0;
                for (auto& c : ctrs2) max_area2 = std::max(max_area2, cv::contourArea(c));

                bool phase2  = (dt >= 2500); // ★ 1500→2500ms 워밍업 연장
                bool area_ok = (max_area2 >= 1500); // ★ area 상한 제거

                bool cx_ok = false;
                if (area_ok && !ctrs2.empty()) {
                    int best_i = 0; double ba = 0;
                    for (int i = 0; i < (int)ctrs2.size(); i++) {
                        double a = cv::contourArea(ctrs2[i]);
                        if (a > ba) { ba = a; best_i = i; }
                    }
                    cv::Moments mm = cv::moments(ctrs2[best_i]);
                    if (mm.m00 > 0) {
                        int cx2 = (int)(mm.m10 / mm.m00);
                        // 우회전 후 라인은 화면 오른쪽~중앙에 있어야 함
                        cx_ok = (cx2 > W2 * 0.3f);
                    }
                }
                bool line_ok = phase2 && area_ok && cx_ok;

                printf("\r[우회전] %.1fs area:%.0f %s      ",
                       dt/1000.0f, max_area2,
                       !phase2 ? "warmup" : (line_ok ? "LINE!" : "searching..."));
                fflush(stdout);

                // ★ 라인 감지 시에만 REACQUIRE 전환 (타임아웃 없음 - 라인 찾을때까지 계속 회전)
                if (line_ok) {
                    printf("\n[우회전 완료] 라인 감지 (area=%.0f, %.1fs)\n", max_area2, dt/1000.0f);
                    g_reacq_dir = DIR_RIGHT;
                    state    = S_REACQUIRE;
                    state_ts = t;
                }
            }
            break;
        }


        case S_REACQUIRE: {
            // ★ 라인 감지 및 무게중심 계산
            int H2 = frame.rows, W2 = frame.cols;
            int y02 = (int)(H2 * 0.65);
            cv::Mat roi2 = frame(cv::Rect(0, y02, W2, H2 - y02));
            cv::Mat gray2, blur2, bin2;
            cv::cvtColor(roi2, gray2, cv::COLOR_BGR2GRAY);
            cv::GaussianBlur(gray2, blur2, cv::Size(7,7), 0);
            cv::threshold(blur2, bin2, 0, 255, cv::THRESH_BINARY_INV | cv::THRESH_OTSU);
            cv::morphologyEx(bin2, bin2, cv::MORPH_OPEN,
                cv::getStructuringElement(cv::MORPH_RECT, cv::Size(3,3)));
            std::vector<std::vector<cv::Point>> ctrs2;
            cv::findContours(bin2, ctrs2, cv::RETR_EXTERNAL, cv::CHAIN_APPROX_SIMPLE);
            double max_area2 = 0; int best2 = -1;
            for (int i = 0; i < (int)ctrs2.size(); i++) {
                double a = cv::contourArea(ctrs2[i]);
                if (a > max_area2) { max_area2 = a; best2 = i; }
            }

            bool line_found = (max_area2 >= 800);
            int  err2 = 9999;
            bool centered = false;
            uint8_t reacq_turn_dir = g_reacq_dir; // 기본은 진입 방향
            if (line_found && best2 >= 0) {
                cv::Moments mm = cv::moments(ctrs2[best2]);
                int cx2 = (mm.m00 != 0) ? (int)(mm.m10 / mm.m00) : W2/2;
                err2 = cx2 - W2/2;
                centered = (abs(err2) <= 50);  // ★ 80 → 50px 엄격하게
                // ★ 라인 보이면 err 부호로 방향 판단 (라인 많은 쪽으로)
                reacq_turn_dir = (err2 > 0) ? DIR_RIGHT : DIR_LEFT;
            }

            // ★ 중앙 정렬 연속 카운터 (static - 상태 내에서 유지)
            static int center_streak = 0;
            if (centered) center_streak++;
            else          center_streak = 0;

            if ((t - last_tx) >= 50) {
                if (!line_found) {
                    // 라인 없음 → g_reacq_dir 방향으로 회전 (라인 찾는 중)
                    send_cmd(sock, g_reacq_dir, REACQ_RPM);
                } else if (!centered) {
                    // 라인 보임 → err 부호 방향으로 정렬
                    send_cmd(sock, reacq_turn_dir, REACQ_RPM);
                } else {
                    // 중앙 정렬됨 → 정지 확인
                    send_cmd(sock, DIR_STOP, 0);
                }
                last_tx = t;
            }

            const char* reacq_st = !line_found ? "NO_LINE" :
                                   !centered    ? (reacq_turn_dir==DIR_LEFT ? "ADJ_L" : "ADJ_R")
                                                : "CENTERED";
            printf("\r[REACQ] %.1f/%.1fs err:%4d %-8s area:%.0f streak:%d dir:%s   ",
                   dt/1000.0f, DUR_REACQ_MS/1000.0f, err2, reacq_st, max_area2,
                   center_streak,
                   (g_reacq_dir==DIR_LEFT)?"L":(g_reacq_dir==DIR_RIGHT)?"R":"ST");
            fflush(stdout);

            // ★ streak 5 달성 시만 S_FOLLOW 전환
            // ★ 타임아웃 와도 streak 미달이면 타이머 리셋 후 계속 정렬
            bool align_done = (line_found && center_streak >= 5);
            bool timeout    = (dt >= DUR_REACQ_MS);

            if (align_done) {
                center_streak = 0;
                g_reacq_dir   = DIR_FORWARD;
                state         = S_REACQ_STABLE;  // ★ 바로 FOLLOW 아닌 안정화 먼저
                state_ts      = t;
                printf("\n[REACQ 완료] 중앙정렬OK → 안정화 구간\n");
            } else if (timeout) {
                state_ts = t;
                printf("\n[REACQ] 타임아웃 리셋 - 계속 정렬중 (streak:%d)\n", center_streak);
            }
            break;
        }


        case S_REACQ_STABLE: {
            // ★ REACQ 완료 후 800ms 직진으로 라인 위에 완전히 올라탄 뒤 S_FOLLOW
            cmd = DIR_FORWARD;
            if ((t - last_tx) >= 50) {
                send_cmd(sock, DIR_FORWARD, DEFAULT_RPM);
                last_tx = t;
            }
            printf("\r[안정화] %.1f/0.8s 직진 중...     ", dt / 1000.0f);
            fflush(stdout);
            if (dt >= 800) {
                start_ts    = t;
                g_reacq_dir = DIR_FORWARD;
                state       = S_FOLLOW;
                state_ts    = t;
                printf("\n[안정화 완료] → S_FOLLOW\n");
            }
            break;
        }

        case S_REACQUIRE_AFTER_UTURN: {
            cmd = DIR_FORWARD;
            if ((t - last_tx) >= 50) {
                send_cmd(sock, DIR_FORWARD, DEFAULT_RPM);
                last_tx = t;
            }
            printf("\r[유턴 후 직진] %.1f / %.1fs",
                   dt / 1000.0f, DUR_REACQ_UTURN_MS / 1000.0f);
            fflush(stdout);
            if (dt >= DUR_REACQ_UTURN_MS) {
                start_ts  = t;
                last_junc = 0;   // ★ 복귀 첫 교차로도 쿨다운 없이 바로 인식
                state     = S_FOLLOW;
                state_ts  = t;
                printf("\n[라인 복귀] 추적 시작\n");
            }
            break;
        }

        case S_DELIVER_WAIT:
            cmd = DIR_STOP;
            if ((t - last_tx) >= 50) {
                send_cmd(sock, DIR_STOP, 0);
                last_tx = t;
            }
            {
                uint64_t wait_sec = dt / 1000;
                printf("\r[PIN 인증 대기] %llus 경과 (도어 닫히면 출발)  ",
                       (unsigned long long)wait_sec);
                fflush(stdout);
                char ws[48];
                snprintf(ws, sizeof(ws), "WAIT PIN %llus", (unsigned long long)wait_sec);
                cv::putText(vis, ws, cv::Point(10, 120),
                            cv::FONT_HERSHEY_SIMPLEX, 0.8, cv::Scalar(0,255,255), 2);
            }
            if (g_door_closed) {
                printf("\n[도어 닫힘 확인] 직진 후 유턴!\n");
                g_door_closed = false;
                state    = S_PRE_UTURN;
                state_ts = t;
                last_tx  = 0;
            }
            break;

        case S_PRE_UTURN: {
            // ★ 도어 닫힘 후 1.5초 직진 → 유턴 (마찰력 확보 + 라인에서 벗어나기)
            cmd = DIR_FORWARD;
            if ((t - last_tx) >= 50) {
                send_cmd(sock, DIR_FORWARD, DEFAULT_RPM);
                last_tx = t;
            }
            printf("\r[유턴 준비] 직진 중 %.1f/2.5s     ", dt / 1000.0f);
            fflush(stdout);
            if (dt >= 2500) {
                printf("\n[유턴 준비 완료] 유턴 시작!\n");
                state    = S_UTURN;
                state_ts = t;
                last_tx  = 0;
            }
            break;
        }

        case S_UTURN: {
            cmd = DIR_UTURN;
            if ((t - last_tx) >= 50) {
                send_cmd(sock, DIR_UTURN, UTURN_RPM);
                last_tx = t;
            }

            // ★ 좌/우회전과 동일 방식: 워밍업 1500ms 후 라인+cx 감지 시 완료
            {
                int H2 = frame.rows, W2 = frame.cols;
                int y02 = (int)(H2 * 0.65);
                cv::Mat roi2 = frame(cv::Rect(0, y02, W2, H2 - y02));
                cv::Mat gray2, blur2, bin2;
                cv::cvtColor(roi2, gray2, cv::COLOR_BGR2GRAY);
                cv::GaussianBlur(gray2, blur2, cv::Size(7,7), 0);
                cv::threshold(blur2, bin2, 0, 255, cv::THRESH_BINARY_INV | cv::THRESH_OTSU);
                cv::morphologyEx(bin2, bin2, cv::MORPH_OPEN,
                    cv::getStructuringElement(cv::MORPH_RECT, cv::Size(3,3)));
                std::vector<std::vector<cv::Point>> ctrs2;
                cv::findContours(bin2, ctrs2, cv::RETR_EXTERNAL, cv::CHAIN_APPROX_SIMPLE);
                double max_area2 = 0;
                for (auto& c : ctrs2) max_area2 = std::max(max_area2, cv::contourArea(c));

                // ★ 워밍업 3000ms (유턴은 180도, 출발지 라인 잔상 무시)
                bool phase2  = (dt >= 3000);
                // ★ area 상한 제거: 유턴 중 라인이 크게 잡혀도 통과
                bool area_ok = (max_area2 >= 1500);

                // ★ 무게중심: 유턴 완료 후 라인이 화면 중앙 ±40% 범위
                bool cx_ok = false;
                if (area_ok && !ctrs2.empty()) {
                    int best_i = 0; double ba = 0;
                    for (int i = 0; i < (int)ctrs2.size(); i++) {
                        double a = cv::contourArea(ctrs2[i]);
                        if (a > ba) { ba = a; best_i = i; }
                    }
                    cv::Moments mm = cv::moments(ctrs2[best_i]);
                    if (mm.m00 > 0) {
                        int cx2 = (int)(mm.m10 / mm.m00);
                        cx_ok = (cx2 > W2 * 0.2f) && (cx2 < W2 * 0.8f);
                    }
                }
                bool line_ok = phase2 && area_ok && cx_ok;

                printf("\r[U턴] %.1fs area:%.0f %s      ",
                       dt/1000.0f, max_area2,
                       !phase2 ? "warmup" : (line_ok ? "LINE!" : "searching..."));
                fflush(stdout);

                if (line_ok) {
                    printf("\n[U턴 완료] 라인 감지 (area=%.0f, %.1fs)\n", max_area2, dt/1000.0f);
                    send_cmd(sock, DIR_STOP, 0);
                    last_tx     = t;
                    returning   = true;
                    junc_count  = 0;
                    g_reacq_dir = DIR_UTURN;
                    state       = S_REACQUIRE_AFTER_UTURN;
                    state_ts    = t;
                } else if (dt >= 12000) {
                    printf("\n[U턴 타임아웃] 12초 초과 → 강제 복귀\n");
                    send_cmd(sock, DIR_STOP, 0);
                    last_tx    = t;
                    returning  = true;
                    junc_count = 0;
                    state      = S_REACQUIRE_AFTER_UTURN;
                    state_ts   = t;
                }
            }
            break;
        }

        case S_FINISHED:
            send_cmd(sock, DIR_STOP, 0);
            mqtt.send_complete();
            printf("\n==============================\n");
            printf("        배달 완료!\n");
            printf("==============================\n");
            dest          = 0;
            junc_count    = 0;
            returning     = false;
            g_destination = 0;
            g_delivery_id = "";
            g_door_closed = false;
            state         = S_WAIT_CMD;
            state_ts      = t;
            printf("다음 배달 명령 대기 중...\n");
            break;
        }

        // 시각화
        const char* stname =
            (state == S_WAIT_CMD)             ? "WAIT"      :
            (state == S_FOLLOW)               ? "FOLLOW"    :
            (state == S_JUNC_STOP)            ? "JUNC_STP"  :
            (state == S_JUNC_STRAIGHT)        ? "JUNC_ST"   :
            (state == S_JUNC_LEFT)            ? "JUNC_L"    :
            (state == S_JUNC_RIGHT)           ? "JUNC_R"    :
            (state == S_REACQUIRE)            ? "REACQ"     :
            (state == S_REACQ_STABLE)         ? "REACQ_ST"  :
            (state == S_REACQUIRE_AFTER_UTURN)? "REACQ_UTN" :
            (state == S_DELIVER_WAIT)         ? "DELIVER"   :
            (state == S_PRE_UTURN)            ? "PRE_UTN"   :
            (state == S_UTURN)                ? "UTURN"     : "FINISH";

        const char* dn = (dest==1)?"A":(dest==2)?"B":(dest==3)?"C":(dest==4)?"D":"?";

        cv::putText(vis, stname, cv::Point(10, 20),
                    cv::FONT_HERSHEY_SIMPLEX, 0.7, cv::Scalar(0,255,255), 2);
        cv::putText(vis, std::string("DEST:")+dn+(returning?" RET":" GO"),
                    cv::Point(10, 45),
                    cv::FONT_HERSHEY_SIMPLEX, 0.6, cv::Scalar(0,255,0), 2);

        char info[64];
        snprintf(info, sizeof(info), "J:%d UTN:%dms DOOR:%s",
                 junc_count, DUR_UTURN_MS,
                 g_door_closed ? "CLOSED" : "OPEN");
        cv::putText(vis, info, cv::Point(10, 68),
                    cv::FONT_HERSHEY_SIMPLEX, 0.45, cv::Scalar(255,200,0), 1);

        cv::imshow("Delivery", vis);
        if ((cv::waitKey(1) & 0xFF) == 'q') { send_estop(sock); break; }
    }

exit_loop:
    g_running = false;
    send_estop(sock);
    cv::destroyAllWindows();
    term_raw_off();
    close(sock);
    cap.release();
    printf("\n프로그램 종료\n");
    return 0;
}
