seongjin-yoon/can-based-autonomous-delivery-car/(commit log)

2026-03-09 update stm32L4
2026-03-23 Revise README for project details and instructions
    Updated project overview, tech stack, architecture, system flow, CAN protocol, MQTT topics, and build instructions in README.
2026-03-23 Revise README with updated architecture and system flow
    Updated README.md to include new images and modify existing content.
2026-03-29 Update device specifications in README.md
