seongjin-yoon/can-based-autonomous-delivery-car/(notices)

Notices in the files:
stmL4_drive/Core/Inc/main.h:
Copyright (c) 2026 STMicroelectronics.
All rights reserved.
This software is licensed under terms that can be found in the LICENSE file
